iic-jku/SG13CMOS_SPARX/ToDo.md

## ToDo List

- [ ] Magic DRC: settle `MIM.e` and `MIM.i` upstream ([IHP-Open-PDK issue 1342](https://github.com/IHP-GmbH/IHP-Open-PDK/issues/1342)) and comment its lines back in (`magic-verify`, `make all`).
- [ ] gdscheck DRC: `make all` stops at `nSDB.e` of the `schottky` PCell until it is fixed in gdscheck ([gdscheck issue 53](https://github.com/aesc-silicon/gdscheck/issues/53)).
- [ ] top-level LVS: see [issue](https://github.com/IHP-GmbH/IHP-Open-PDK/issues/1041) for `Rmetal`, fixed by the open [PR 1121](https://github.com/IHP-GmbH/IHP-Open-PDK/pull/1121). Once it is merged, add `klayout-lvs` and `magic-lvs` of `sparx160_top` to `make all`, as the [Makefile Structure](README.md#makefile-structure) figure already shows. The LVS netlist targets look for `schematic/xschem/<CELL>.sch`, and there is no `sparx160_top.sch` (the top-level schematics are `sparx_top.sch` and `sparx_top_lvs.sch`): @simi1505
- [ ] WPD EM result: the committed `sparx160_wpd` Palace run (2026-07-29) predates `914c021`, which moved the port 2 and 3 markers to the output edges of the arms (same metal). Re-solve with `make sim-wpd-em`, refit the WPD models, rerun the WPD and composed-core benches and update the documentation numbers. On the current GDS at 160 GHz S21 is -3.37 dB instead of -4.42 dB and S11 -44.0 dB instead of -19.9 dB, and the fit is passive (largest singular value 0.999)
- [ ] EM metal model: the EM solves use gds2palace's surface metal, which reads the BPF about 0.5 dB too lossy and the WPD within 1 % ([check of 2026-10-18](verification/em/metal_model/README.md)). Switch to volume metal, or repeat the check, when one of the conditions in its section "When to revisit and switch to volume" holds.
- [ ] Container requirement for kpex: `klayout-pex` runs the kpex 2.5D engine since 2026-10-26 and needs kpex 0.7.0 or later, the `2026.10` image ships 0.6.8. IIC-OSIC-TOOLS `next_release` pins `klayout-pex==0.6.15` and the FEM plugins require `klayout-pex<0.7` (iic-jku/klayout-pex#499, 2026-11-06). Once an image ships 0.7.0 or later, move the requirement in `README.md`, `AGENTS.md` and `doc/index.qmd` to it when `next_release` is merged.
