iic-jku/SG13CMOS_SPARX/release/v.2.0.0/img/sparx160_top_black.png

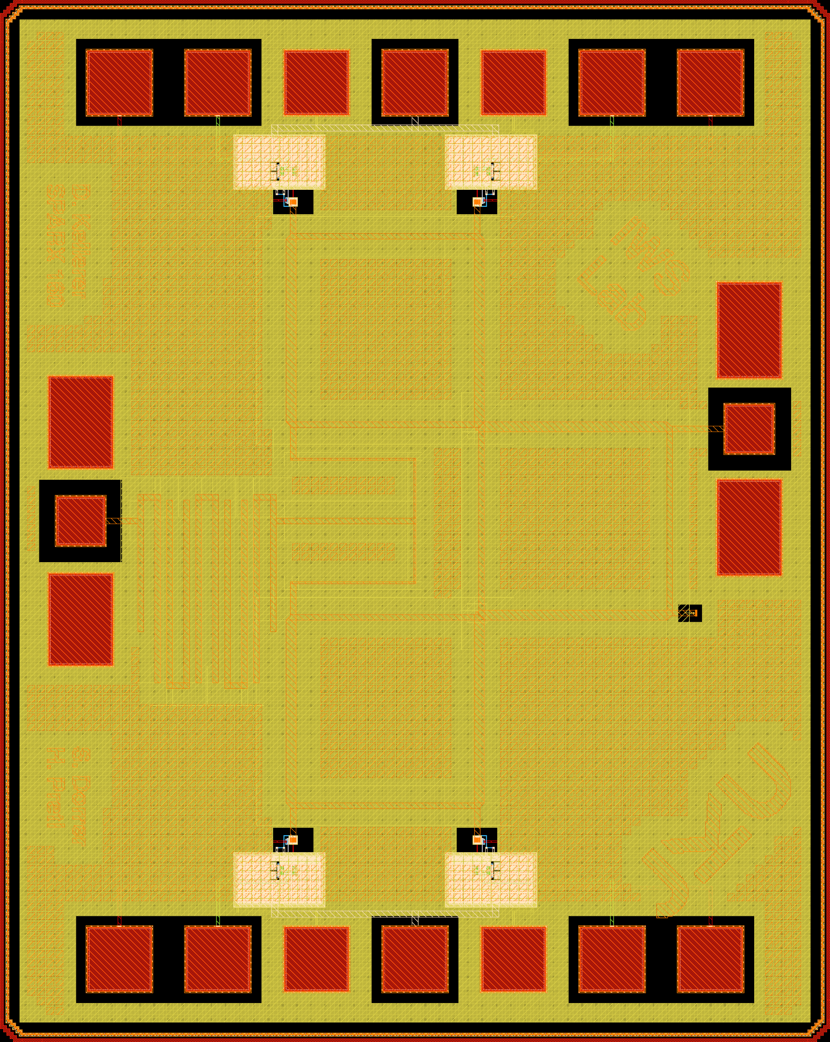
release/v.2.0.0/img/sparx160_top_black.png
