iic-jku/SG13CMOS_SPARX/render/img/sparx160_top_black.png

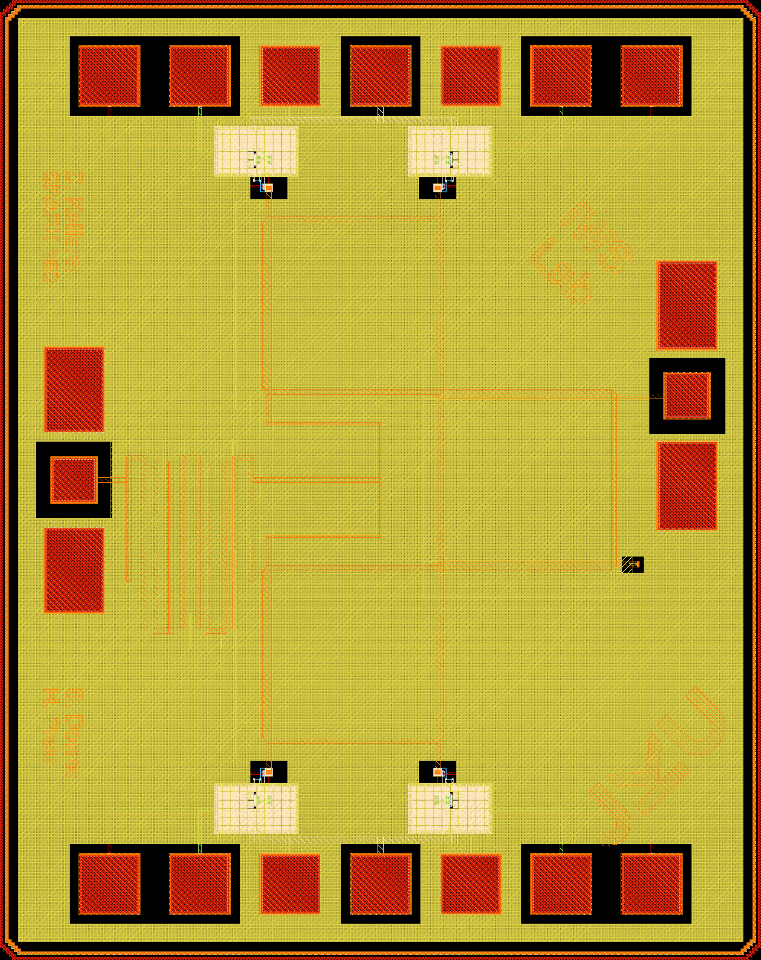
render/img/sparx160_top_black.png
