iic-jku/SG13CMOS_SPARX/measurements/README.md

# Measurements

- The LO & RF pads are measured with a wafer prober.
- The supply & power detector pads are bonded to a PCB and measured with an oscilloscope.
