iic-jku/SG13CMOS_SPARX/testbenches/xschem/plot_simulations/data/sparx_powdet_sbd_nf.csv

f_hz | asd_v | beta_f_vw | nep_w | nep_nopnp_w | g_usb | g_lsb | vif_dbv | nf_dsb_db | nf_ssb_db | nf_dsb_nopnp_db | asd_pumped_v | nf_dsb_quiescent_db | nf_ssb_quiescent_db | nf_dsb_quiescent_nopnp_db | g_usb_pac | g_lsb_pac | asd_pnoise_v | nf_dsb_pnoise_db
1.000000e+03 | 1.130809e-05 | 4.121629e+01 | 2.743597e-07 | 1.492750e-08 | 6.694820e-01 | 6.694820e-01 | -7.521049e+01 | 1.054971e+02 | 1.085074e+02 | 7.822756e+01 | 1.378732e-05 | 1.037753e+02 | 1.067856e+02 | 7.848862e+01 | 6.705324e-01 | 6.705324e-01 | 1.392545e-05 | 1.055769e+02
1.121999e+03 | 1.067562e-05 | 4.121629e+01 | 2.590146e-07 | 1.409269e-08 | 6.694820e-01 | 6.694820e-01 | -7.521049e+01 | 1.049972e+02 | 1.080075e+02 | 7.772770e+01 | 1.301619e-05 | 1.032754e+02 | 1.062857e+02 | 7.798876e+01 | 6.705324e-01 | 6.705324e-01 | 1.314659e-05 | 1.050770e+02
1.258881e+03 | 1.007853e-05 | 4.121629e+01 | 2.445277e-07 | 1.330458e-08 | 6.694820e-01 | 6.694820e-01 | -7.521049e+01 | 1.044973e+02 | 1.075076e+02 | 7.722785e+01 | 1.228818e-05 | 1.027754e+02 | 1.057857e+02 | 7.748890e+01 | 6.705324e-01 | 6.705324e-01 | 1.241129e-05 | 1.045770e+02
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
