iic-jku/SG13CMOS_SPARX/testbenches/xschem/plot_simulations/data/sparx_powdet_sbd_nf_compare.csv

f_hz | nf_dsb_transient_db | nf_dsb_hbnoise_db | nf_dsb_quiescent_db | nf_dsb_pnoise_db
2.034508e+08 | 5.064286e+01 | 5.157581e+01 | 4.930607e+01 | 5.167020e+01
3.051762e+08 | 4.947177e+01 | 4.966990e+01 | 4.727942e+01 | 4.976526e+01
4.069016e+08 | 4.730309e+01 | 4.838228e+01 | 4.592759e+01 | 4.847743e+01
5.086270e+08 | 4.711075e+01 | 4.741862e+01 | 4.491943e+01 | 4.751307e+01
6.103524e+08 | 4.678775e+01 | 4.665551e+01 | 4.412024e+01 | 4.674906e+01
7.120778e+08 | 4.634512e+01 | 4.601815e+01 | 4.345311e+01 | 4.611071e+01
8.138032e+08 | 4.613354e+01 | 4.548366e+01 | 4.289822e+01 | 4.557515e+01
9.155286e+08 | 4.585363e+01 | 4.501806e+01 | 4.242330e+01 | 4.510845e+01
1.017254e+09 | 4.445102e+01 | 4.460697e+01 | 4.201529e+01 | 4.469622e+01
1.118979e+09 | 4.350666e+01 | 4.423879e+01 | 4.166216e+01 | 4.432689e+01
1.220705e+09 | 4.376138e+01 | 4.391744e+01 | 4.137000e+01 | 4.400435e+01
1.322430e+09 | 4.331988e+01 | 4.362371e+01 | 4.111272e+01 | 4.370943e+01
1.424156e+09 | 4.332632e+01 | 4.335006e+01 | 4.088029e+01 | 4.343459e+01
1.525881e+09 | 4.377379e+01 | 4.310853e+01 | 4.068538e+01 | 4.319185e+01
1.627606e+09 | 4.345494e+01 | 4.288227e+01 | 4.050659e+01 | 4.296440e+01
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
