iic-jku/SG13CMOS_SPARX/testbenches/xschem/plot_simulations/data/sparx_powdet_sbd_nf_lo.csv

plo_dbm | nf_dsb_db | nf_dsb_nopnp_db | g_usb | s_out_pumped | nf_dsb_quiescent_db | nf_dsb_quiescent_nopnp_db | g_usb_pnoise | s_out_pnoise | nf_dsb_pnoise_db
-5.602060e+01 | 8.858381e+01 | 8.348676e+01 | 1.150324e-06 | 6.665798e-18 | 8.866429e+01 | 8.355086e+01 | 1.150004e-06 | 6.665712e-18 | 8.858494e+01
-5.270889e+01 | 8.527201e+01 | 8.017498e+01 | 2.466040e-06 | 6.665794e-18 | 8.535249e+01 | 8.023906e+01 | 2.465321e-06 | 6.665794e-18 | 8.527325e+01
-4.939717e+01 | 8.196035e+01 | 7.686323e+01 | 5.286606e-06 | 6.665965e-18 | 8.204072e+01 | 7.692729e+01 | 5.285070e-06 | 6.665966e-18 | 8.196159e+01
-4.608546e+01 | 7.864880e+01 | 7.355147e+01 | 1.133328e-05 | 6.666325e-18 | 7.872894e+01 | 7.361551e+01 | 1.133013e-05 | 6.666326e-18 | 7.864998e+01
-4.277375e+01 | 7.533742e+01 | 7.023963e+01 | 2.429647e-05 | 6.667087e-18 | 7.541706e+01 | 7.030363e+01 | 2.429034e-05 | 6.667089e-18 | 7.533849e+01
-3.946203e+01 | 7.202642e+01 | 6.692763e+01 | 5.208932e-05 | 6.668705e-18 | 7.210501e+01 | 6.699158e+01 | 5.207908e-05 | 6.668709e-18 | 7.202725e+01
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
