iic-jku/SG13CMOS_SPARX/testbenches/xschem/plot_simulations/data/sparx_powdet_sbd_nf_lo_m16.csv

plo_dbm | nf_dsb_db | nf_dsb_nopnp_db | g_usb | s_out_pumped | nf_dsb_quiescent_db | nf_dsb_quiescent_nopnp_db | g_usb_pnoise | s_out_pnoise | nf_dsb_pnoise_db
-5.602060e+01 | 6.917580e+01 | 6.747046e+01 | 3.481615e-05 | 2.326602e-18 | 6.924058e+01 | 6.752415e+01 | 3.475927e-05 | 2.326463e-18 | 6.918263e+01
-5.270889e+01 | 6.586971e+01 | 6.416570e+01 | 7.455526e-05 | 2.327077e-18 | 6.593361e+01 | 6.421718e+01 | 7.451310e-05 | 2.327070e-18 | 6.587215e+01
-4.939717e+01 | 6.255949e+01 | 6.085634e+01 | 1.598319e-04 | 2.327951e-18 | 6.262176e+01 | 6.090533e+01 | 1.597290e-04 | 2.327942e-18 | 6.256226e+01
-4.608546e+01 | 5.925049e+01 | 5.754863e+01 | 3.426061e-04 | 2.329193e-18 | 5.931044e+01 | 5.759401e+01 | 3.423827e-04 | 2.329179e-18 | 5.925329e+01
-4.277375e+01 | 5.594287e+01 | 5.424292e+01 | 7.343130e-04 | 2.330927e-18 | 5.599959e+01 | 5.428316e+01 | 7.338210e-04 | 2.330906e-18 | 5.594573e+01
-3.946203e+01 | 5.263739e+01 | 5.094033e+01 | 1.573511e-03 | 2.333287e-18 | 5.268972e+01 | 5.097330e+01 | 1.572396e-03 | 2.333257e-18 | 5.264041e+01
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
