iic-jku/SG13CMOS_SPARX/testbenches/xschem/plot_simulations/data/sparx_powdet_sbd_nf_lo_m1_pex.csv

plo_dbm | nf_dsb_db | nf_dsb_nopnp_db | g_usb | s_out_pumped | nf_dsb_quiescent_db | nf_dsb_quiescent_nopnp_db | g_usb_pnoise | s_out_pnoise | nf_dsb_pnoise_db
-5.602060e+01 | 8.942465e+01 | 8.448999e+01 | 5.841552e-07 | 4.113088e-18 | 8.950918e+01 | 8.455669e+01 | 5.839001e-07 | 4.113039e-18 | 8.942653e+01
-5.270889e+01 | 8.611285e+01 | 8.117821e+01 | 1.252296e-06 | 4.113085e-18 | 8.619739e+01 | 8.124490e+01 | 1.251735e-06 | 4.113085e-18 | 8.611484e+01
-4.939717e+01 | 8.280119e+01 | 7.786648e+01 | 2.684623e-06 | 4.113179e-18 | 8.288563e+01 | 7.793314e+01 | 2.683421e-06 | 4.113180e-18 | 8.280318e+01
-4.608546e+01 | 7.948963e+01 | 7.455473e+01 | 5.755206e-06 | 4.113377e-18 | 7.957385e+01 | 7.462136e+01 | 5.752694e-06 | 4.113378e-18 | 7.949156e+01
-4.277375e+01 | 7.617822e+01 | 7.124293e+01 | 1.233802e-05 | 4.113792e-18 | 7.626200e+01 | 7.130951e+01 | 1.233293e-05 | 4.113793e-18 | 7.618005e+01
-3.946203e+01 | 7.286714e+01 | 6.793098e+01 | 2.645121e-05 | 4.114670e-18 | 7.295000e+01 | 6.799751e+01 | 2.644163e-05 | 4.114672e-18 | 7.286876e+01
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
