iic-jku/SG13CMOS_SPARX/testbenches/xschem/plot_simulations/data/sparx_powdet_sbd_nf_m16.csv

f_hz | asd_v | beta_f_vw | nep_w | nep_nopnp_w | g_usb | g_lsb | vif_dbv | nf_dsb_db | nf_ssb_db | nf_dsb_nopnp_db | asd_pumped_v | nf_dsb_quiescent_db | nf_ssb_quiescent_db | nf_dsb_quiescent_nopnp_db | g_usb_pac | g_lsb_pac | asd_pnoise_v | nf_dsb_pnoise_db
1.000000e+03 | 5.685518e-06 | 2.507852e+02 | 2.267087e-08 | 3.261517e-09 | 4.424674e+00 | 4.424674e+00 | -6.700906e+01 | 8.405388e+01 | 8.706418e+01 | 7.146366e+01 | 3.001859e-06 | 8.960148e+01 | 9.261178e+01 | 7.276050e+01 | 4.452730e+00 | 4.452730e+00 | 2.940810e-06 | 8.384796e+01
1.121999e+03 | 5.367524e-06 | 2.507852e+02 | 2.140288e-08 | 3.079119e-09 | 4.424674e+00 | 4.424674e+00 | -6.700906e+01 | 8.355397e+01 | 8.656427e+01 | 7.096399e+01 | 2.833967e-06 | 8.910155e+01 | 9.211185e+01 | 7.226064e+01 | 4.452730e+00 | 4.452730e+00 | 2.776333e-06 | 8.334806e+01
1.258881e+03 | 5.067315e-06 | 2.507852e+02 | 2.020580e-08 | 2.906923e-09 | 4.424674e+00 | 4.424674e+00 | -6.700906e+01 | 8.305406e+01 | 8.606436e+01 | 7.046432e+01 | 2.675465e-06 | 8.860163e+01 | 9.161193e+01 | 7.176078e+01 | 4.452730e+00 | 4.452730e+00 | 2.621055e-06 | 8.284815e+01
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
