iic-jku/SG13CMOS_SPARX/testbenches/xschem/plot_simulations/figures/sparx_core_le_tb_tran_ngspice.png

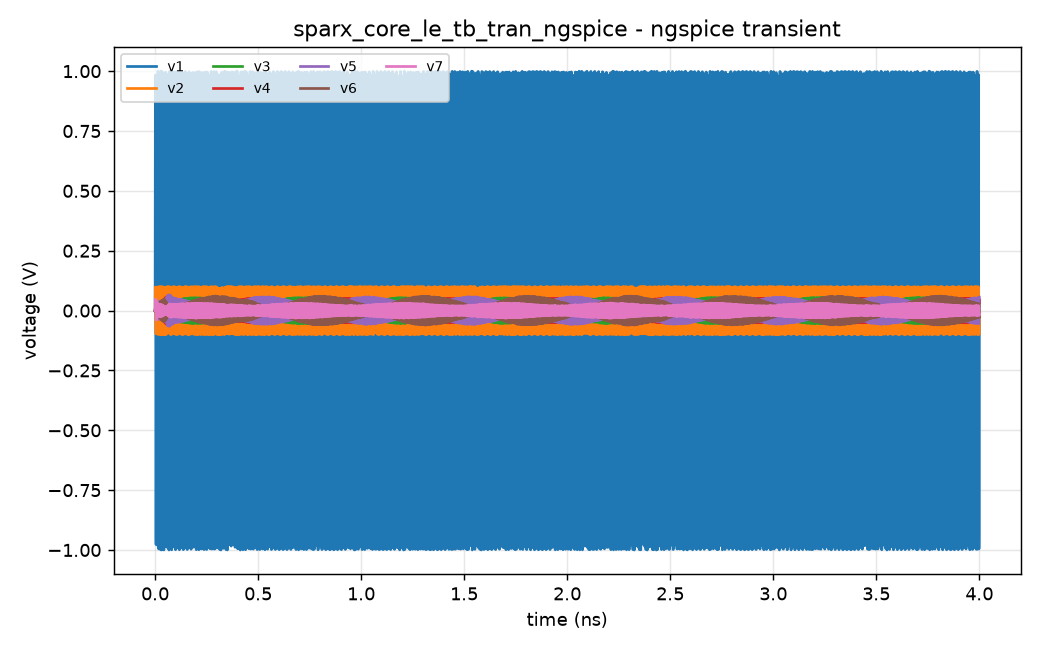
testbenches/xschem/plot_simulations/figures/sparx_core_le_tb_tran_ngspice.png
