iic-jku/SG13CMOS_SPARX/testbenches/xschem/plot_simulations/figures/sparx_core_tb_acsp_vacask.png

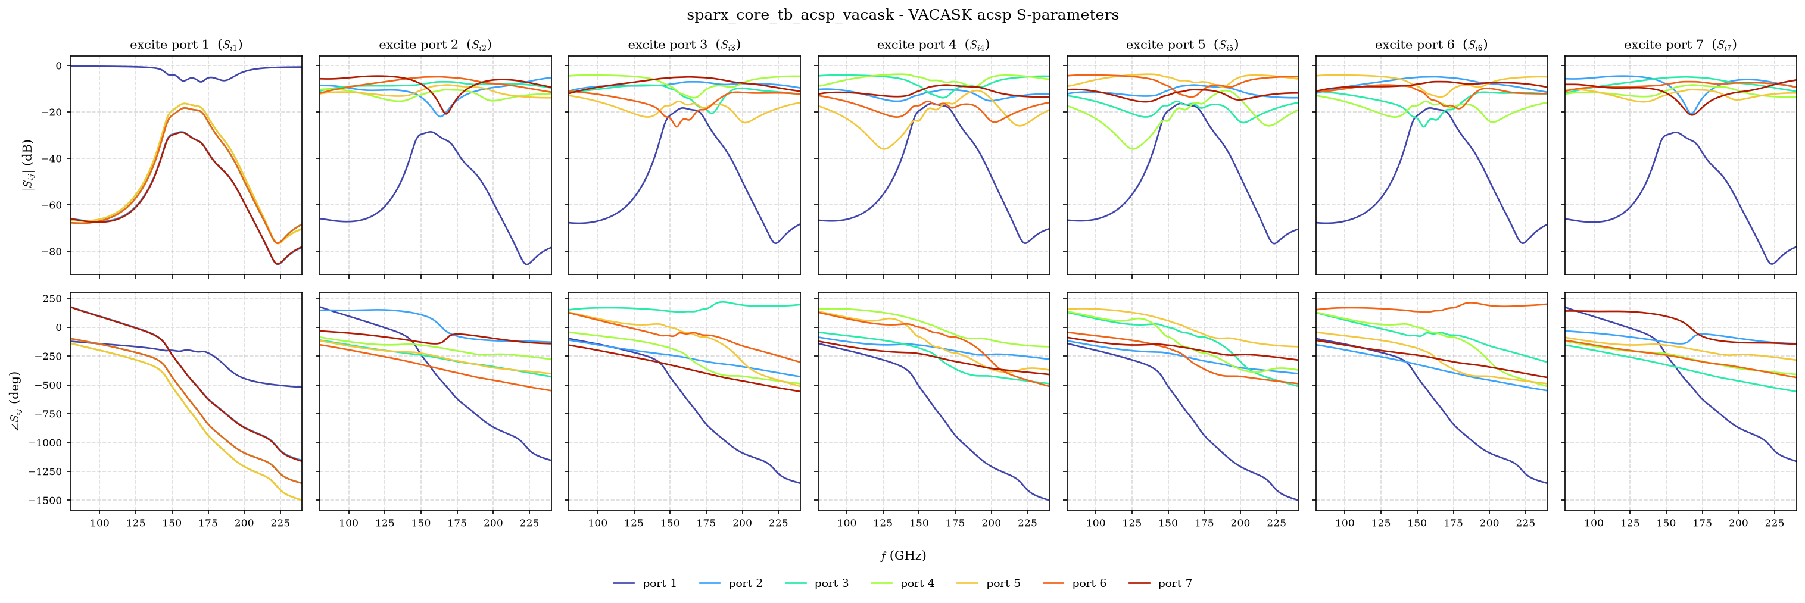
testbenches/xschem/plot_simulations/figures/sparx_core_tb_acsp_vacask.png
