iic-jku/SG13CMOS_SPARX/testbenches/xschem/plot_simulations/figures/sparx_powdet_sbd_hb_sweep_V-W.png

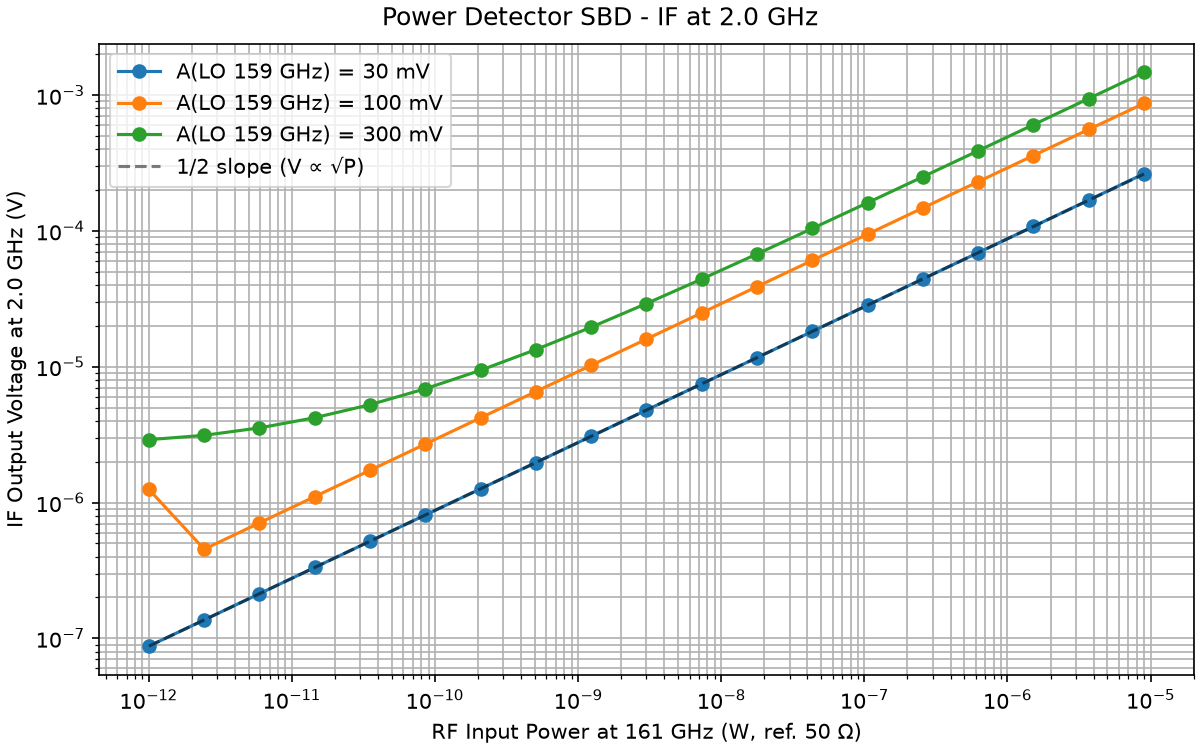
testbenches/xschem/plot_simulations/figures/sparx_powdet_sbd_hb_sweep_V-W.png
