iic-jku/SG13CMOS_SPARX/testbenches/xschem/plot_simulations/figures/sparx_powdet_sbd_nf_m16.png

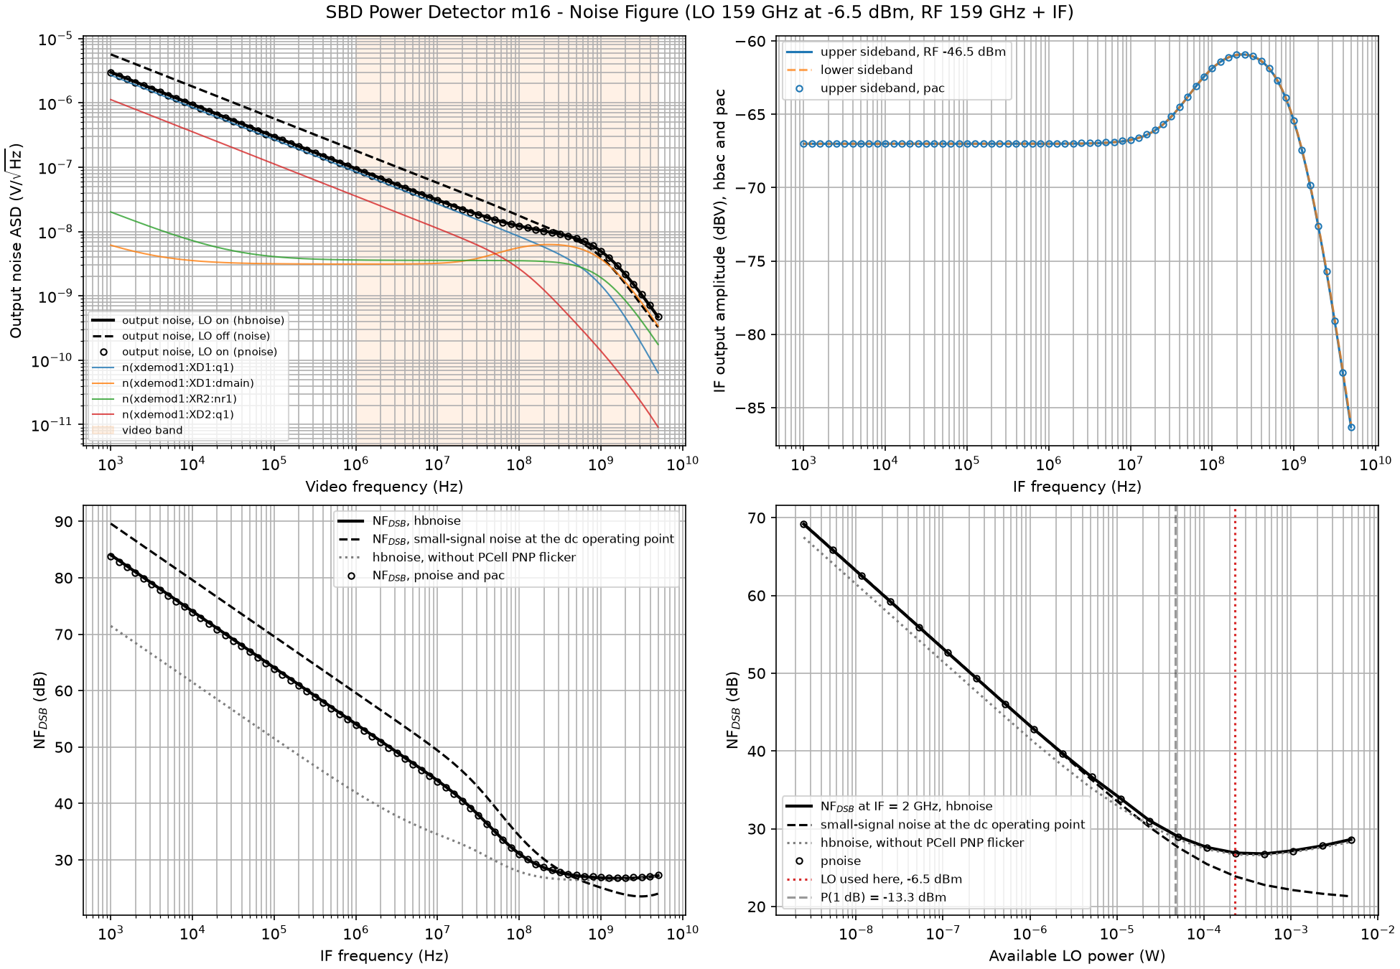
testbenches/xschem/plot_simulations/figures/sparx_powdet_sbd_nf_m16.png
