iic-jku/SG13CMOS_SPARX/testbenches/xschem/plot_simulations/figures/sparx_powdet_sbd_pss_sweep_c0_pex.png

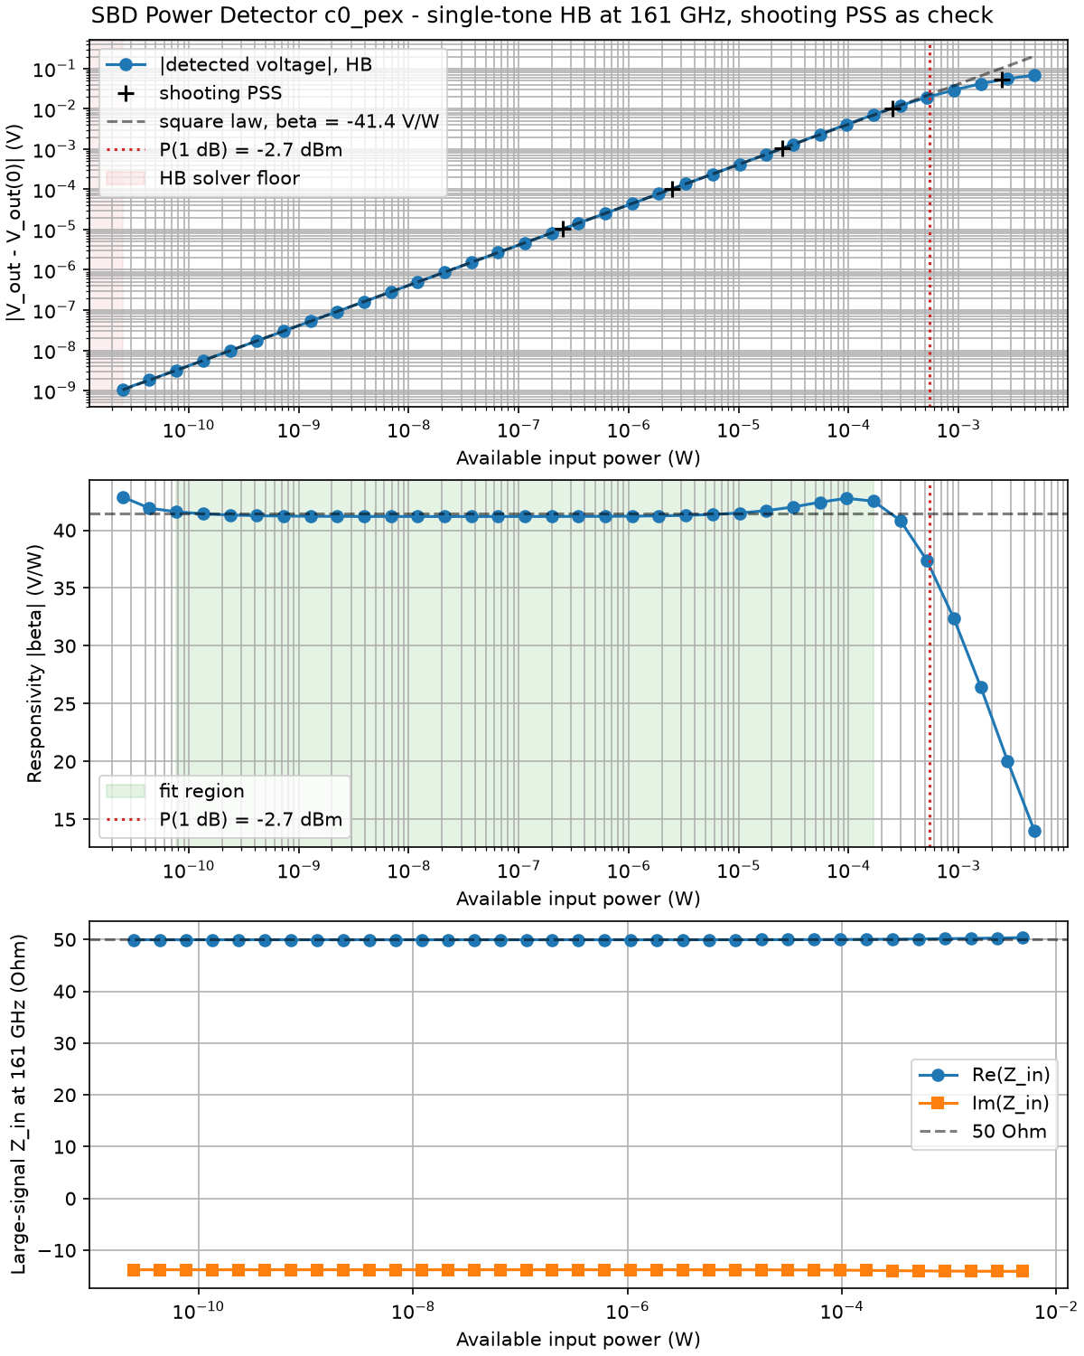
testbenches/xschem/plot_simulations/figures/sparx_powdet_sbd_pss_sweep_c0_pex.png
