iic-jku/SG13CMOS_SPARX/testbenches/xschem/plot_simulations/figures/sparx_powdet_sbd_tb_ngspice.png

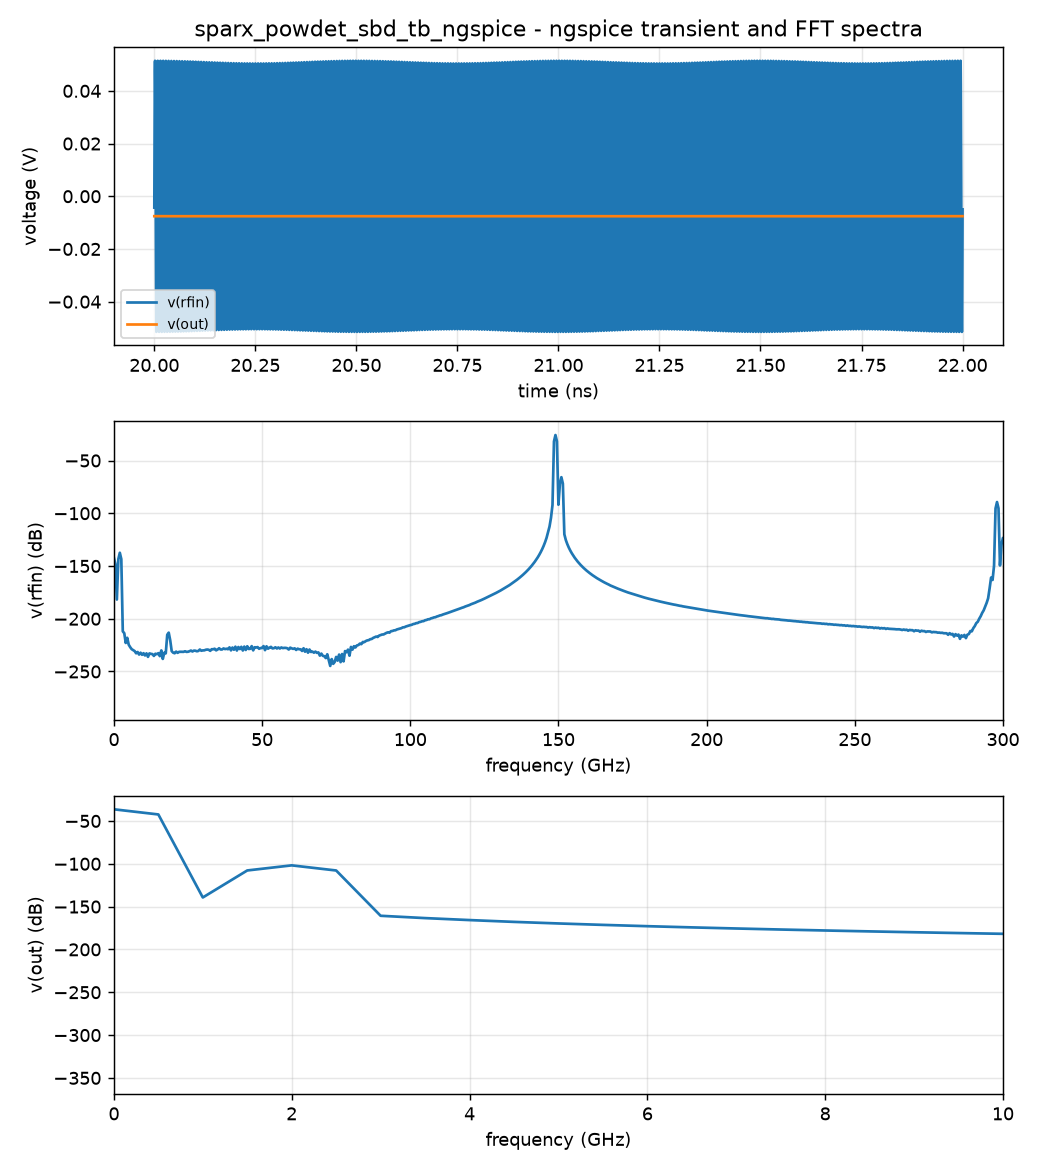
testbenches/xschem/plot_simulations/figures/sparx_powdet_sbd_tb_ngspice.png
