iic-jku/SG13CMOS_SPARX/testbenches/xschem/plot_simulations/figures/sparx_top_le_tn.png

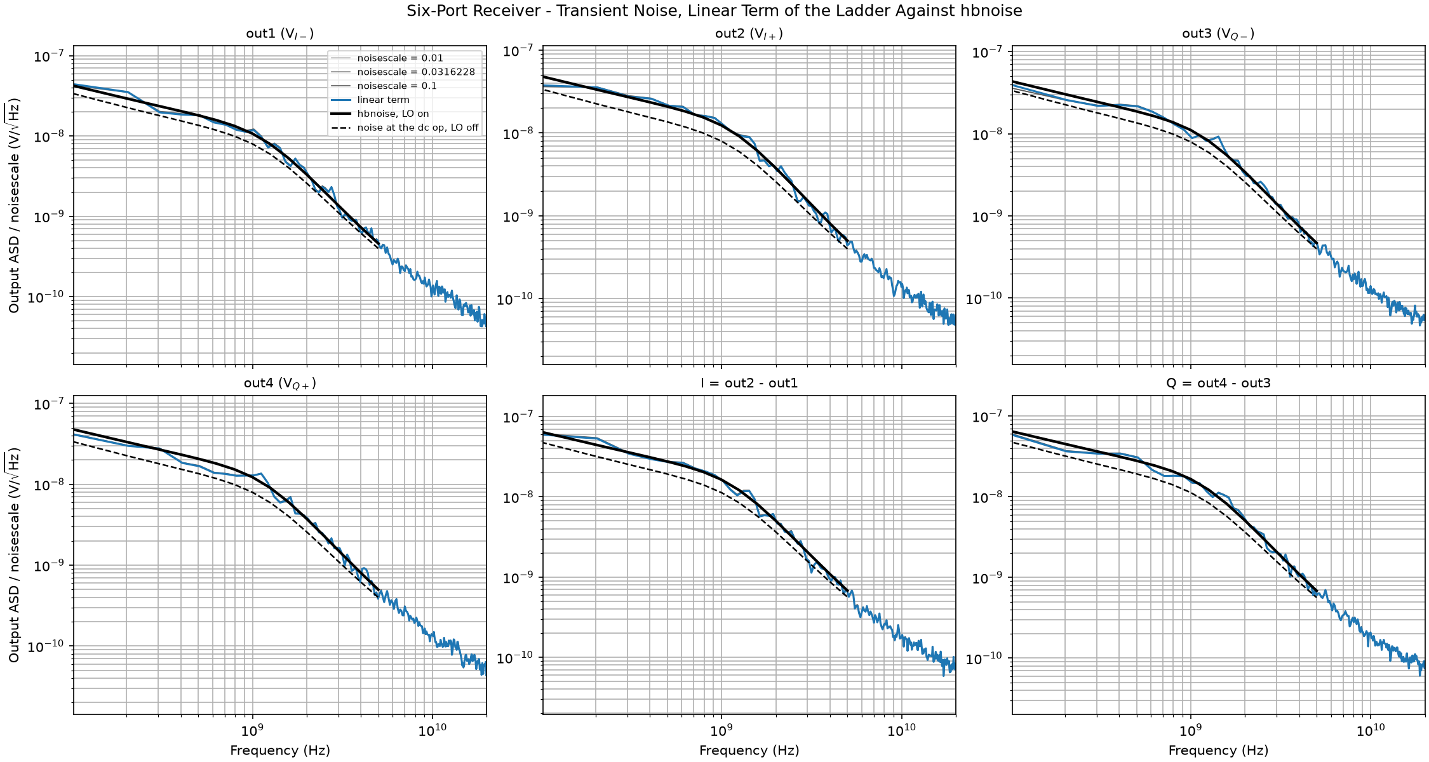
testbenches/xschem/plot_simulations/figures/sparx_top_le_tn.png
