iic-jku/SG13CMOS_SPARX/testbenches/xschem/plot_simulations/figures/sparx_wpd_le_tb_acsp_ngspice.png

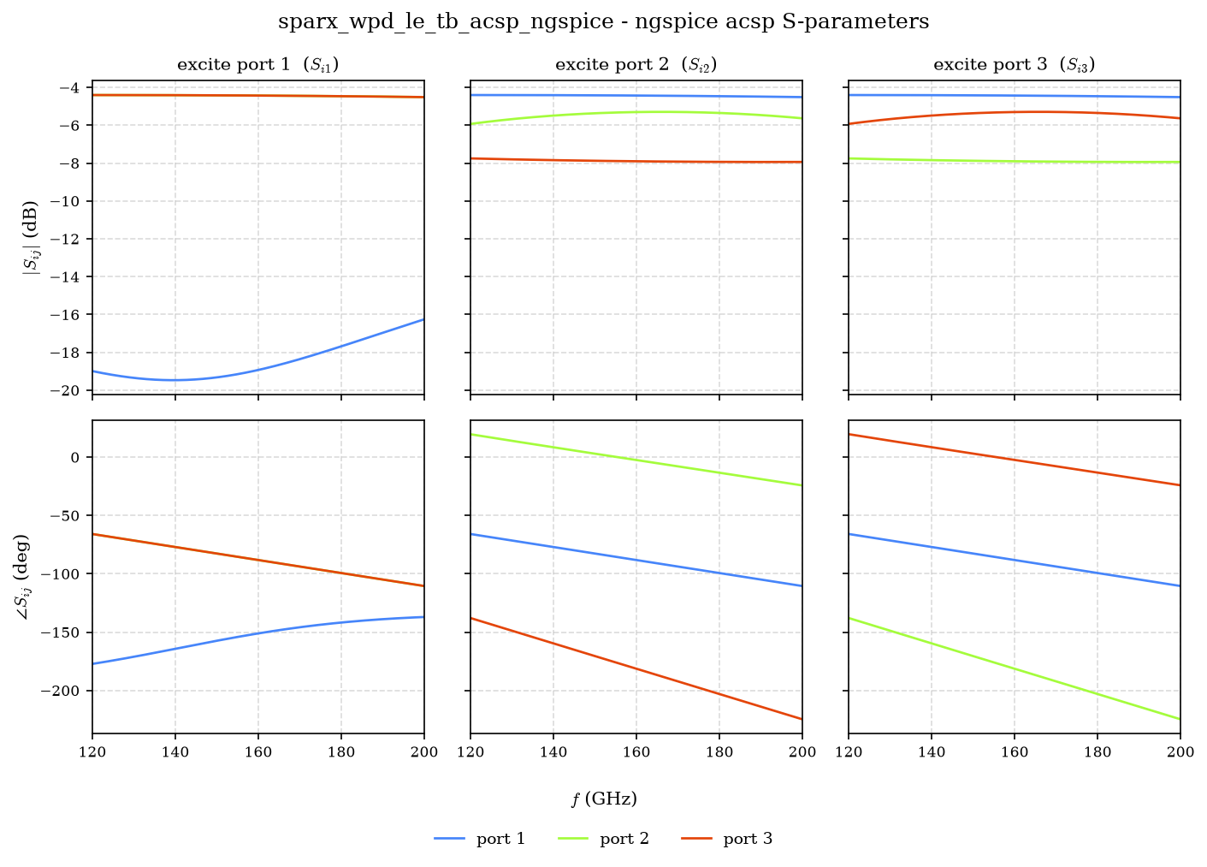
testbenches/xschem/plot_simulations/figures/sparx_wpd_le_tb_acsp_ngspice.png
