iic-jku/SG13CMOS_SPARX/doc/fig/sparx_blockdiagram/sparx_blockdiagram.pdf

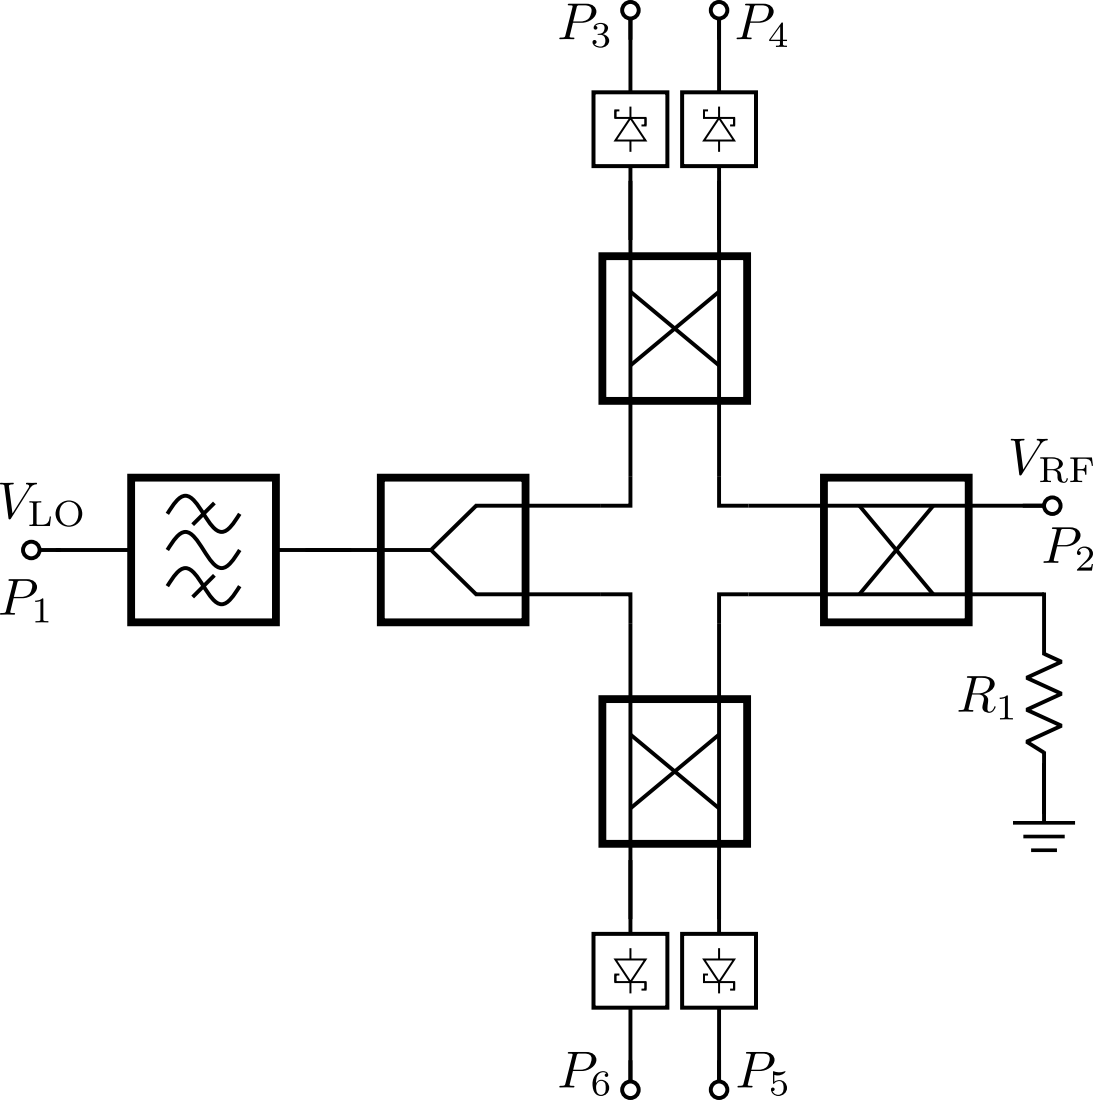
[picture p41: page 1]
