iic-jku/SG13CMOS_SPARX/netlist/spice/sparx_core_le.spice

* sparx_core_le - lumped-element equivalent (Ngspice / SPICE3)
* generated by snp2le
* EQUIVALENT CIRCUIT FOR VECTOR FITTED S-MATRIX
* Created using scikit-rf vectorFitting.py
* 
* 
* thermal noise of the passive: kT(I - S S^H) at the ports, from a spectral factor of this fit
* sources Rnz_e1..Rnz_e7 (0.25 ohm, the only noisy elements), 161 states nz_x*, controlled sources Gnz_*
.SUBCKT sparx_core_le p1 p2 p3 p4 p5 p6 p7
V1 p1 s1 0
R1 s1 0 50 noisy=0
Gd1_1 0 s1 p1 0 -0.002913191401
Fd1_1 0 s1 V1 -0.14565957
Gr1_re_1_1 0 s1 x1_re_a1 0 -681684.6204
Gr1_im_1_1 0 s1 x1_im_a1 0 -193017.7012
Gr2_1_1 0 s1 x2_a1 0 1.690031537
Gr3_re_1_1 0 s1 x3_re_a1 0 218871.3477
Gr3_im_1_1 0 s1 x3_im_a1 0 28370.06673
Gr4_re_1_1 0 s1 x4_re_a1 0 -55709.83268
Gr4_im_1_1 0 s1 x4_im_a1 0 358585.0299
Gr5_re_1_1 0 s1 x5_re_a1 0 -386285.1597
Gr5_im_1_1 0 s1 x5_im_a1 0 530108.9632
Gr6_re_1_1 0 s1 x6_re_a1 0 -911288.5966
Gr6_im_1_1 0 s1 x6_im_a1 0 -1477332.821
Gr7_re_1_1 0 s1 x7_re_a1 0 175365.6199
Gr7_im_1_1 0 s1 x7_im_a1 0 193816.5488
Gr8_re_1_1 0 s1 x8_re_a1 0 -337453.7
Gr8_im_1_1 0 s1 x8_im_a1 0 639438.242
Gr9_re_1_1 0 s1 x9_re_a1 0 539783.5979
Gr9_im_1_1 0 s1 x9_im_a1 0 1987898.741
Gr10_re_1_1 0 s1 x10_re_a1 0 347917.4973
Gr10_im_1_1 0 s1 x10_im_a1 0 -109390.5837
Gr11_re_1_1 0 s1 x11_re_a1 0 175974.6261
Gr11_im_1_1 0 s1 x11_im_a1 0 -630844.6317
Gr12_re_1_1 0 s1 x12_re_a1 0 527543.177
Gr12_im_1_1 0 s1 x12_im_a1 0 -251256.5977
Gd1_2 0 s1 p2 0 -7.062813979e-06
Fd1_2 0 s1 V2 -0.000353140699
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
Fx5_re_a3 0 x5_re_a3 V3 4.775459023e-06
Rp5_re_re_a3 0 x5_re_a3 1 noisy=0
Gp5_re_im_a3 0 x5_re_a3 x5_im_a3 0 1.86425479
Cx5_im_a3 x5_im_a3 0 2.551196837e-12
Gp5_im_re_a3 0 x5_im_a3 x5_re_a3 0 -1.86425479
Rp5_im_im_a3 0 x5_im_a3 1 noisy=0
Cx6_re_a3 x6_re_a3 0 4.347339998e-12
Gx6_re_a3 0 x6_re_a3 p3 0 7.959644309e-08
Fx6_re_a3 0 x6_re_a3 V3 3.979822155e-06
Rp6_re_re_a3 0 x6_re_a3 1 noisy=0
Gp6_re_im_a3 0 x6_re_a3 x6_im_a3 0 5.043445659
Cx6_im_a3 x6_im_a3 0 4.347339998e-12
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
