iic-jku/SG13CMOS_SPARX/netlist/pex/sparx_powdet_sbd_magic_pex_3.spice

* PEX produced on Sun Aug 30 02:50:36 PM CEST 2026 using /foss/tools/sak/sak-pex.sh with m=3 and s=1 (extresist threshold=1000 mOhm, minres=100 mOhm, mindelay=0 ps)
* NGSPICE file created from sparx_powdet_sbd_pex.ext - technology: ihp-sg13g2
* CORRECTED 2026-09-04 as a workaround for magic#557, which this extraction hits:
* the coupling capacitance of the m=3 full-RC run is emitted twice, and the substrate
* capacitance that extresist parks on internal nodes of the ground net is lost when
* scripts/powdet_variant.py idealises vss. The capacitance per net pair was rebuilt
* from an <extract all> plus <ext2spice hierarchy off> reference of the same layout.
* Devices and resistors are unchanged from the sak-pex.sh run named above, only the
* C lines differ. Post-layout responsivity moves 41.4 -> 38.8 V/W, the video
* bandwidth does not move. Regenerating with sak-pex.sh alone reintroduces the error.

.subckt sparx_powdet_sbd_pex vout vref vdd rfin vss
X0 vout.t6 dw_8122_4047# vdd.t16 vdd.t0 sg13_lv_pmos ad=0.95p pd=5.38u as=0.95p ps=5.38u w=5u l=0.13u
X1 a_8474_2725# vss.t42 cap_cmim l=10u w=10u
X2 vout.t18 dw_8122_4047# vss.t13 vss.t12 sg13_lv_nmos ad=0.475p pd=2.88u as=0.475p ps=2.88u w=2.5u l=0.13u
X3 vdd vss.t44 cap_cmim l=10u w=10u
X4 vdd vss.t44 cap_cmim l=10u w=10u
X5 vss.t21 dw_8122_4047# vout.t14 vss.t22 sg13_lv_nmos ad=0.475p pd=2.88u as=0.475p ps=2.88u w=2.5u l=0.13u
X6 a_8474_2725# vss.t42 cap_cmim l=10u w=10u
X7 vdd.t28 vdd.t26 vdd.t22 vdd.t0 sg13_lv_pmos ad=0.95p pd=5.38u as=0 ps=0 w=5u l=0.13u
X8 a_8474_2725# vss.t42 cap_cmim l=10u w=10u
X9 a_8474_2725# vss.t42 cap_cmim l=10u w=10u
X10 vss.t3 dw_8122_4047# vout.t15 vss.t19 sg13_lv_nmos ad=0.475p pd=2.88u as=0.475p ps=2.88u w=2.5u l=0.13u
X11 vout.t4 dw_8122_4047# vdd.t6 vdd.t0 sg13_lv_pmos ad=0.95p pd=5.38u as=0.95p ps=5.38u w=5u l=0.13u
X12 vdd vss.t44 cap_cmim l=10u w=10u
X13 vdd vss.t44 cap_cmim l=10u w=10u
X14 a_8474_2725# vss.t42 cap_cmim l=10u w=10u
X15 a_8474_2725# vss.t42 cap_cmim l=10u w=10u
X16 vout.t12 dw_8122_4047# vss.t33 vss.t32 sg13_lv_nmos ad=0.475p pd=2.88u as=0.475p ps=2.88u w=2.5u l=0.13u
X17 vout.t3 dw_8122_4047# vdd.t4 vdd.t0 sg13_lv_pmos ad=0.95p pd=5.38u as=0.95p ps=5.38u w=5u l=0.13u
X18 vdd.t1 dw_9390_4047# vref.t0 vdd.t0 sg13_lv_pmos ad=0.95p pd=5.38u as=0.95p ps=5.38u w=5u l=0.13u
X19 vout.t2 dw_8122_4047# vdd.t20 vdd.t0 sg13_lv_pmos ad=0.95p pd=5.38u as=0.95p ps=5.38u w=5u l=0.13u
X20 vss.t5 dw_8122_4047# vout.t5 vss.t4 sg13_lv_nmos ad=0.475p pd=2.88u as=0.475p ps=2.88u w=2.5u l=0.13u
X21 vout.t9 dw_8122_4047# vss.t1 vss.t18 sg13_lv_nmos ad=0.475p pd=2.88u as=0.475p ps=2.88u w=2.5u l=0.13u
X22 vdd vss.t44 cap_cmim l=9u w=6.8u
X23 vdd vss.t44 cap_cmim l=10u w=10u
X24 vdd vss.t42 cap_cmim l=10u w=10u
X25 a_8474_2725# vss.t42 cap_cmim l=10u w=10u
X26 vout.t1 dw_8122_4047# vdd.t18 vdd.t0 sg13_lv_pmos ad=0.95p pd=5.38u as=0.95p ps=5.38u w=5u l=0.13u
X27 a_8474_2725# vss.t42 cap_cmim l=10u w=10u
X28 vss.t27 dw_8122_4047# vout.t11 vss.t28 sg13_lv_nmos ad=0.475p pd=2.88u as=0.475p ps=2.88u w=2.5u l=0.13u
X29 vout.t13 dw_8122_4047# vss.t16 vss.t15 sg13_lv_nmos ad=0.475p pd=2.88u as=0.475p ps=2.88u w=2.5u l=0.13u
X30 a_8474_2725# vss.t42 cap_cmim l=10u w=10u
X31 vdd vss.t44 cap_cmim l=10u w=10u
X32 a_8474_2725# vss.t42 cap_cmim l=10u w=10u
X33 a_8474_2725# vss.t42 cap_cmim l=10u w=10u
X34 vss.t24 dw_8122_4047# vout.t10 vss.t25 sg13_lv_nmos ad=0.475p pd=2.88u as=0.475p ps=2.88u w=2.5u l=0.13u
X35 vdd vss.t44 cap_cmim l=10u w=10u
X36 a_8474_2725# vss.t42 cap_cmim l=10u w=10u
X37 a_8474_2725# vss.t42 cap_cmim l=10u w=10u
X38 rfin a_8232_4131# cap_cmim l=10u w=10u
X39 a_8474_2725# vss.t42 cap_cmim l=10u w=10u
X40 vdd vss.t44 cap_cmim l=10u w=10u
X41 a_8474_2725# vdd.t23 vss.t41 rhigh l=2u w=0.5u
X42 vout.t8 dw_8122_4047# vdd.t8 vdd.t0 sg13_lv_pmos ad=0.95p pd=5.38u as=0.95p ps=5.38u w=5u l=0.13u
X43 a_8232_4131# dw_8122_4047# vss schottky_nbl1 l=1.2u w=2.655u
X44 vdd.t14 dw_8122_4047# vout.t6 vdd.t0 sg13_lv_pmos ad=0.95p pd=5.38u as=0.95p ps=5.38u w=5u l=0.13u
X45 vss.t10 dw_8122_4047# vout.t18 vss.t11 sg13_lv_nmos ad=0.475p pd=2.88u as=0.475p ps=2.88u w=2.5u l=0.13u
X46 vdd vss.t44 cap_cmim l=10u w=10u
X47 vdd.t2 dw_8122_4047# vout.t7 vdd.t0 sg13_lv_pmos ad=0.95p pd=5.38u as=0.95p ps=5.38u w=5u l=0.13u
X48 a_8474_2725# vss.t42 cap_cmim l=10u w=10u
X49 vout.t15 dw_8122_4047# vss.t21 vss.t20 sg13_lv_nmos ad=0.475p pd=2.88u as=0.475p ps=2.88u w=2.5u l=0.13u
X50 vss.t7 dw_8122_4047# vout.t17 vss.t8 sg13_lv_nmos ad=0.475p pd=2.88u as=0.475p ps=2.88u w=2.5u l=0.13u
X51 vout.t16 dw_8122_4047# vdd.t22 vdd.t0 sg13_lv_pmos ad=0.95p pd=5.38u as=0.95p ps=5.38u w=5u l=0.13u
X52 a_9398_3295# a_8474_2725# vss.t74 rsil l=2.5u w=0.5u
X53 vref.t1 dw_9390_4047# vss.t3 vss.t2 sg13_lv_nmos ad=0.475p pd=2.88u as=0.475p ps=2.88u w=2.5u l=0.13u
X54 vdd vss.t44 cap_cmim l=10u w=10u
X55 vss.t30 dw_8122_4047# vout.t12 vss.t31 sg13_lv_nmos ad=0.475p pd=2.88u as=0.475p ps=2.88u w=2.5u l=0.13u
X56 dw_9390_4047# vref.t2 vss.t34 rppd l=1.5u w=0.5u
X57 vdd vss.t44 cap_cmim l=10u w=10u
X58 vdd.t3 dw_8122_4047# vout.t3 vdd.t0 sg13_lv_pmos ad=0.95p pd=5.38u as=0.95p ps=5.38u w=5u l=0.13u
X59 vdd vss.t42 cap_cmim l=10u w=10u
X60 vout.t0 dw_8122_4047# vdd.t1 vdd.t0 sg13_lv_pmos ad=0.95p pd=5.38u as=0.95p ps=5.38u w=5u l=0.13u
X61 vss.t37 vss.t35 vss.t5 vss.t36 sg13_lv_nmos ad=0.85p pd=5.68u as=0 ps=0 w=2.5u l=0.13u
X62 a_8474_2725# vss.t42 cap_cmim l=10u w=10u
X63 vdd.t18 dw_8122_4047# vout.t2 vdd.t0 sg13_lv_pmos ad=0.95p pd=5.38u as=0.95p ps=5.38u w=5u l=0.13u
X64 vout.t19 dw_8122_4047# vdd.t10 vdd.t0 sg13_lv_pmos ad=0.95p pd=5.38u as=0.95p ps=5.38u w=5u l=0.13u
X65 vss.t16 dw_8122_4047# vout.t9 vss.t17 sg13_lv_nmos ad=0.475p pd=2.88u as=0.475p ps=2.88u w=2.5u l=0.13u
X66 vdd vss.t42 cap_cmim l=10u w=10u
X67 vout.t20 dw_8122_4047# vss.t34 rppd l=1.5u w=0.5u
X68 vdd vss.t44 cap_cmim l=10u w=10u
X69 a_8474_2725# vss.t42 cap_cmim l=10u w=10u
X70 vdd vss.t44 cap_cmim l=10u w=10u
X71 a_8474_2725# vss.t42 cap_cmim l=10u w=10u
X72 vdd.t16 dw_8122_4047# vout.t1 vdd.t0 sg13_lv_pmos ad=0.95p pd=5.38u as=0.95p ps=5.38u w=5u l=0.13u
X73 a_8474_2725# vss.t42 cap_cmim l=10u w=10u
X74 vss.t13 dw_8122_4047# vout.t13 vss.t14 sg13_lv_nmos ad=0.475p pd=2.88u as=0.475p ps=2.88u w=2.5u l=0.13u
X75 a_8474_2725# vss.t42 cap_cmim l=10u w=10u
X76 vdd vss.t44 cap_cmim l=10u w=10u
X77 a_8474_2725# vss.t42 cap_cmim l=10u w=10u
X78 vout.t14 dw_8122_4047# vss.t24 vss.t23 sg13_lv_nmos ad=0.475p pd=2.88u as=0.475p ps=2.88u w=2.5u l=0.13u
X79 a_8474_2725# vss.t42 cap_cmim l=10u w=10u
X80 vdd vss.t44 cap_cmim l=10u w=10u
X81 vdd.t6 dw_8122_4047# vout.t8 vdd.t0 sg13_lv_pmos ad=0.95p pd=5.38u as=0.95p ps=5.38u w=5u l=0.13u
X82 vdd vss.t44 cap_cmim l=10u w=10u
X83 vss.t33 vss.t38 vss.t40 vss.t39 sg13_lv_nmos ad=0.475p pd=2.88u as=0 ps=0 w=2.5u l=0.13u
X84 a_8474_2725# vss.t42 cap_cmim l=10u w=10u
X85 vdd vss.t44 cap_cmim l=9u w=6.8u
X86 vout.t7 dw_8122_4047# vdd.t14 vdd.t0 sg13_lv_pmos ad=0.95p pd=5.38u as=0.95p ps=5.38u w=5u l=0.13u
X87 vdd vss.t44 cap_cmim l=10u w=10u
X88 vdd.t4 dw_8122_4047# vout.t4 vdd.t0 sg13_lv_pmos ad=0.95p pd=5.38u as=0.95p ps=5.38u w=5u l=0.13u
X89 vout.t17 dw_8122_4047# vss.t10 vss.t9 sg13_lv_nmos ad=0.475p pd=2.88u as=0.475p ps=2.88u w=2.5u l=0.13u
X90 a_8474_2725# vss.t42 cap_cmim l=10u w=10u
X91 vref.t0 dw_9390_4047# vdd.t2 vdd.t0 sg13_lv_pmos ad=0.95p pd=5.38u as=0.95p ps=5.38u w=5u l=0.13u
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
C80 vout.n3 vss 0.486563f
C81 vout.t1 vss 0.19346f
C82 vout.n4 vss 0.273404f
C83 vout.t6 vss 3.80559f
C84 vout.n5 vss 0.273412f
C85 vout.t7 vss 0.175718f
C86 vout.n6 vss 0.510612f
C87 vout.t4 vss 0.175714f
C88 vout.t19 vss 0.175718f
C89 vout.t0 vss 0.175718f
C90 vout.t8 vss 0.175714f
C91 vout.t3 vss 0.175714f
C92 vout.n7 vss 1.91055f
C93 vout.t20 vss 0.0616759f
C94 vout.t17 vss 0.0891768f
C95 vout.t13 vss 0.0891768f
C96 vout.t15 vss 0.0894355f
C97 vout.t14 vss 0.0891768f
C98 vout.t10 vss 0.0891768f
C99 vout.t11 vss 0.0891768f
C100 vout.t12 vss 0.0903329f
C101 vout.n8 vss 0.25799f
C102 vout.t9 vss 0.0891768f
C103 vout.t18 vss 0.0891768f
C104 vout.t5 vss 0.0891768f
C105 vout.n9 vss 1.62907f
C106 vref.t0 vss 1.03435f
C107 vref.t1 vss 0.0731088f
C108 vref.n0 vss 0.392249f
C109 vref.t2 vss 0.0471537f
C110 vref.n1 vss 0.48784f
Cfix0 a_8474_2725# vss 56.9921f
Cfix1 a_9398_3295# vss 0.89308f
Cfix2 dw_8122_4047# vss 11.656f
Cfix3 rfin vss 3.22536f
.ends
