iic-jku/SG13CMOS_SPARX/netlist/spice/blc_le.spice

* blc_le - lumped-element equivalent (Ngspice / SPICE3)
* generated by snp2le
* EQUIVALENT CIRCUIT FOR VECTOR FITTED S-MATRIX
* Created using scikit-rf vectorFitting.py
* 
* 
.SUBCKT blc_le p1 p2 p3 p4
V1 p1 s1 0
R1 s1 0 50
Gd1_1 0 s1 p1 0 -0.00135903038
Fd1_1 0 s1 V1 -0.06795151899
Gr1_re_1_1 0 s1 x1_re_a1 0 -466102.2317
Gr1_im_1_1 0 s1 x1_im_a1 0 -83272.7305
Gr2_re_1_1 0 s1 x2_re_a1 0 139727.8544
Gr2_im_1_1 0 s1 x2_im_a1 0 -492632.0781
Gr3_re_1_1 0 s1 x3_re_a1 0 337054.193
Gr3_im_1_1 0 s1 x3_im_a1 0 -240793.1822
Gd1_2 0 s1 p2 0 0.001064045615
Fd1_2 0 s1 V2 0.05320228073
Gr1_re_1_2 0 s1 x1_re_a2 0 -285620.5483
Gr1_im_1_2 0 s1 x1_im_a2 0 -281808.9666
Gr2_re_1_2 0 s1 x2_re_a2 0 264463.2381
Gr2_im_1_2 0 s1 x2_im_a2 0 -6580.419213
Gr3_re_1_2 0 s1 x3_re_a2 0 96732.57859
Gr3_im_1_2 0 s1 x3_im_a2 0 -564472.4499
Gd1_3 0 s1 p3 0 -0.0008051656617
Fd1_3 0 s1 V3 -0.04025828309
Gr1_re_1_3 0 s1 x1_re_a3 0 242930.7388
Gr1_im_1_3 0 s1 x1_im_a3 0 -233454.3812
Gr2_re_1_3 0 s1 x2_re_a3 0 -157092.2518
Gr2_im_1_3 0 s1 x2_im_a3 0 636552.9974
Gr3_re_1_3 0 s1 x3_re_a3 0 -304552.5846
Gr3_im_1_3 0 s1 x3_im_a3 0 216608.6521
Gd1_4 0 s1 p4 0 -0.003097367713
Fd1_4 0 s1 V4 -0.1548683856
Gr1_re_1_4 0 s1 x1_re_a4 0 165199.8513
Gr1_im_1_4 0 s1 x1_im_a4 0 -157622.1514
Gr2_re_1_4 0 s1 x2_re_a4 0 -184383.0743
Gr2_im_1_4 0 s1 x2_im_a4 0 -417784.8992
Gr3_re_1_4 0 s1 x3_re_a4 0 -136337.8753
Gr3_im_1_4 0 s1 x3_im_a4 0 464043.5166
Cx1_re_a1 x1_re_a1 0 1.399967176e-12
Gx1_re_a1 0 x1_re_a1 p1 0 8.64148994e-08
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
Gx3_re_a4 0 x3_re_a4 p4 0 5.940927442e-08
Fx3_re_a4 0 x3_re_a4 V4 2.970463721e-06
Rp3_re_re_a4 0 x3_re_a4 1
Gp3_re_im_a4 0 x3_re_a4 x3_im_a4 0 3.14158227
Cx3_im_a4 x3_im_a4 0 3.025545542e-12
Gp3_im_re_a4 0 x3_im_a4 x3_re_a4 0 -3.14158227
Rp3_im_im_a4 0 x3_im_a4 1
.ENDS blc_le
