iic-jku/SG13CMOS_SPARX/(commit log)

2026-06-01 updated testbenches
    [sparx_powdet_sbd_tb.sch, sparx_powdet_sbd_tb_vacask.sch]
2026-06-02 updated testbenches and added eval scripts
    [sparx_powdet_sbd_tb_hb_vacask.sch, sparx_powdet_sbd_tb_tn_vacask.sch]
2026-06-19 updated HB simulation and added results
    [sparx_powdet_sbd_hb_sweep_alo_100mV.csv, sparx_powdet_sbd_hb_sweep_alo_300mV.csv, sparx_powdet_sbd_hb_sweep_alo_30mV.csv, sparx_powdet_sbd_hb_sweep_ref.csv]
2026-07-04 added Ngspice testbenches
    [sparx_blc_le_tb_acsp_ngspice.sch, sparx_bpf_le_tb_acsp_ngspice.sch, sparx_wpd_le_tb_acsp_ngspice.sch]
2026-07-04 added VACASK testbenches
    [sparx_blc_le_tb_acsp_vacask.sch, sparx_bpf_le_tb_acsp_vacask.sch, sparx_wpd_le_tb_acsp_vacask.sch]
2026-07-04 added transient noise VACASK testbench
    [sparx_powdet_sbd_tb_tn_vacask.sch]
2026-07-04 added HB VACASK testbench
    [sparx_powdet_sbd_tb_hb_tf_vacask.sch]
2026-07-04 updated sparx_powdet_sbd.sch / .sym
    [sparx_powdet_sbd.sch]
2026-07-04 added top-level schematics and symbols
    [sparx_lvs_top.sch, sparx_top.sch]
2026-07-04 renamed `sparx_lvs_top` to `sparx_top_lvs`
    [sparx_top_lvs.sch]
2026-07-04 added `sparx_core.sch` and `sparx_core.sym`
    [sparx_core.sch]
2026-07-04 updated `sparx_core.sch`
    [sparx_core.sch]
2026-07-04 added `sparx_core_tb_acsp_ngspice.sch`
    [sparx_core_tb_acsp_ngspice.sch]
2026-07-04 added `sparx_core_le_tb_acsp_ngspice.sch`
    [sparx_core_le_tb_acsp_ngspice.sch]
2026-07-04 added `sparx_top_tb_tran_ngspice.sch`
    [sparx_top_tb_tran_ngspice.sch]
2026-07-05 relocated / renamed files in `verification/em` folder
    [domain-E.csv, error-indicators.csv, port-I.csv, port-S.csv, port-V.csv]
2026-07-05 relocated simulation VACASK Python scripts
    [sparx_blc_le_tb_acsp_vacask.sch, sparx_bpf_le_tb_acsp_vacask.sch, sparx_powdet_sbd_tb_hb_tf_vacask.sch, sparx_powdet_sbd_tb_hb_vacask.sch, sparx_powdet_sbd_tb_tn_vacask.sch, sparx_wpd_le_tb_acsp_vacask.sch]
2026-07-05 renamed `sparx_powdet_sbd_tb_ngspice.sch`
    [sparx_powdet_sbd_tb_ngspice.sch]
2026-07-08 updated WPD and BLC testbenches
    [sparx_blc_le_tb_acsp_ngspice.sch, sparx_blc_le_tb_acsp_vacask.sch, sparx_wpd_le_tb_acsp_ngspice.sch, sparx_wpd_le_tb_acsp_vacask.sch]
2026-07-08 added WPD and BLC transient testbenches
    [sparx_blc_le_tb_tran_ngspice.sch, sparx_wpd_le_tb_tran_ngspice.sch]
2026-07-08 added top-level Ngspice transient simulation
    [sparx_core_le_tb_acsp_ngspice.sch, sparx_core_le_tb_tran_ngspice.sch, sparx_core_tb_acsp_ngspice.sch, sparx_top.sch, sparx_top_le.sch, sparx_top_le_tb_tran_ngspice.sch]
2026-07-14 removed `ntap` / `ptap` from `sparx_powdet_sbd.sch`
    [sparx_powdet_sbd.sch]
2026-07-14 reran snp2le and simulations of BPF, WPD and BLC with de-embedded
2026-07-14 unwrapped phase in testbenches
    [sparx_blc_le_tb_acsp_ngspice.sch, sparx_bpf_le_tb_acsp_ngspice.sch, sparx_core_le_tb_acsp_ngspice.sch, sparx_core_tb_acsp_ngspice.sch, sparx_wpd_le_tb_acsp_ngspice.sch]
2026-07-14 added `sparx_core_le_tb_acsp_vacask.sch` and `sparx_core_tb_acsp_vacask.sch` testbenches
    [sparx_core_le_tb_acsp_vacask.sch, sparx_core_tb_acsp_vacask.sch]
2026-07-14 fixed phase imbalance in Xschem testbenches
    [sparx_core_le_tb_acsp_ngspice.sch, sparx_core_tb_acsp_ngspice.sch]
2026-07-14 archived some testbenches
    [sparx_powdet_sbd_tb_hb_tf_vacask.sch, sparx_powdet_sbd_tb_tn_vacask.sch]
2026-07-14 updated `sparx_core_le_tb_acsp_ngspice.sch` and `sparx_core_tb_acsp_ngspice.sch` with all s-parameter export
    [sparx_core_le_tb_acsp_ngspice.sch, sparx_core_tb_acsp_ngspice.sch]
2026-07-14 updated copyright headers
    [sparx_blc_le_tb_acsp_ngspice.sch, sparx_blc_le_tb_acsp_vacask.sch, sparx_blc_le_tb_tran_ngspice.sch, sparx_bpf_le_tb_acsp_ngspice.sch, sparx_bpf_le_tb_acsp_vacask.sch, sparx_core.sch, sparx_core_le_tb_acsp_ngspice.sch, sparx_core_le_tb_acsp_vacask.sch]
2026-07-15 sparx160_core drc clean (except slit M5) with DBU 1nm
    The slit violation is okay and is fixed later into the layout.
2026-07-15 pd + toplevel gds DRC clean (as far as possible) with dbu set to 1nm (IHP TO branch)
2026-07-15 adapted `six_port_gen.py` to deterministic PDK port naming (gdsfactory 9.45)
    The container update (gdsfactory 9.45 / new kfactory+KLayout) changed the
    box enumeration order that auto-names the DS_/G_ ports of the PDK mos
    cells. The script's hardcoded port names and list indices then picked the
    wrong fingers/gates: the short drain via stack was never placed, the
    output_stage bbox grew, the pmos landed misplaced/rotated and vout/vref/
    vss shorted -- both KLayout and Magic+Netgen LVS failed on regeneration.
    Companion change in IHP-GDSFactory-Addon (`ihp/cells/mos_transistors.py`):
    DS_/G_ ports are now renumbered positionally left to right, so the names
    below are stable across tool versions.
    C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
2026-07-15 reran verification flow
    - PD: Magic LVS / DRC / PEX + KLayout LVS / DRC clean
    - Top-Level: Magic DRC clean. KLayout has off-grid errors.
2026-07-16 renamed palace model folders
    [domain-E.csv, error-indicators.csv, port-I.csv, port-S.csv, port-V.csv]
2026-07-17 renamed palace model to `sparx160_core_data`
    [domain-E.csv, error-indicators.csv, port-I.csv, port-S.csv, port-V.csv]
2026-07-17 updated `README` and comments of the filter parameters
2026-07-21 added pin labels for lvs checks
2026-07-22 reran SPARX flow
    [sparx_powdet_sbd_hb_sweep_V-W_alo_100mV.csv, sparx_powdet_sbd_hb_sweep_V-W_alo_300mV.csv, sparx_powdet_sbd_hb_sweep_V-W_alo_30mV.csv, sparx_powdet_sbd_hb_sweep_V-W_ref.csv, sparx_powdet_sbd_hb_sweep_alo_100mV.csv, sparx_powdet_sbd_hb_sweep_alo_300mV.csv, sparx_powdet_sbd_hb_sweep_alo_30mV.csv, sparx_powdet_sbd_hb_sweep_ref.csv]
2026-07-22 executed `make regression` --> ready for `2026.07` IIC-OSIC-TOOLS release
    [domain-E.csv, error-indicators.csv, port-I.csv, port-S.csv, port-V.csv]
2026-07-22 [Server] executed make all and make release
    [domain-E.csv, error-indicators.csv, port-I.csv, port-S.csv, port-V.csv]
2026-07-28 relocated pin reorder scripts to IIC-OSIC-TOOLS container
2026-07-28 reworked circuit-level simulation flow
    - added `plot_simulations` structure for testbench plotting
    - moved plot scripts, `sim_data` (-> `data/`) and figures into `testbenches/plot_simulations/` (template-consistent)
    - added `plot_n_port_tb_acsp_ngspice.py` / `plot_n_port_tb_tran_ngspice.py` (via `ngspice2python.py`), renamed VACASK eval scripts to `plot_*_vacask.py`
    - `sim-xschem` now runs `ngspice -b` / `vacask` in batch mode; new `sim-view-xschem SCRIPT=<scriptname>` target
    - updated testbench `wrdata`/`postprocess` paths, fixed stale `.save` include (powdet) and HB netlist glob, updated `README.md` and `REUSE.toml`
    [sparx_blc_le_tb_acsp_ngspice.sch, sparx_blc_le_tb_acsp_vacask.sch, sparx_blc_le_tb_tran_ngspice.sch, sparx_bpf_le_tb_acsp_ngspice.sch, sparx_bpf_le_tb_acsp_vacask.sch, sparx_core_le_tb_acsp_ngspice.sch, sparx_core_le_tb_acsp_vacask.sch, sparx_core_le_tb_tran_ngspice.sch]
2026-07-28 added `xschem` folder layer for template and snp2le consistency
    - moved schematics to `schematic/xschem/` and the Xschem testbenches (incl. `xschemrc`, `sim_range.*`, `plot_simulations/`) to `testbenches/xschem/`, matching `ihp-sg13g2-ams-chip-template` and `snp2le`
    - renamed `SCH_DIR` to `XSCHEM_SCH_DIR` (= `schematic/xschem`); `XSCHEM_TB_DIR` = `testbenches/xschem`, `SIM_PLOT_DIR` = `testbenches/xschem/plot_simulations`; netlists now go to `testbenches/xschem/simulations/`
    - updated relative paths in all testbenches (`wrdata`, VACASK `postprocess`, netlist includes), both `xschemrc` files, and the plot script anchors
    - updated `.gitignore`, `REUSE.toml`, `regression.yml` artifact paths, an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
    [sparx_blc_le_tb_acsp_ngspice.sch, sparx_blc_le_tb_acsp_vacask.sch, sparx_blc_le_tb_tran_ngspice.sch, sparx_bpf_le_tb_acsp_ngspice.sch, sparx_bpf_le_tb_acsp_vacask.sch, sparx_core.sch, sparx_core_le_tb_acsp_ngspice.sch, sparx_core_le_tb_acsp_vacask.sch]
2026-07-29 updated plotting scripts for fancier plots
    [sparx_powdet_sbd_hb_sweep_V-W_alo_100mV.csv, sparx_powdet_sbd_hb_sweep_V-W_alo_300mV.csv, sparx_powdet_sbd_hb_sweep_V-W_alo_30mV.csv, sparx_powdet_sbd_hb_sweep_V-W_ref.csv, sparx_powdet_sbd_hb_sweep_alo_100mV.csv, sparx_powdet_sbd_hb_sweep_alo_300mV.csv, sparx_powdet_sbd_hb_sweep_alo_30mV.csv, sparx_powdet_sbd_hb_sweep_ref.csv]
2026-07-31 Reworked EM simulation GDS generation and Makefile flow
    `six_port_gen.py` now exports the BLC, WPD, BPF, and six-port core with their
    Palace port markers (layers 201..207) to `verification/em/layout/`, so the EM
    simulations always run on the same structures that are instantiated in the
    chip. The four standalone generator scripts in `verification/em/scripts/` are
    removed, together with their duplicated design parameters.
    The `sim-*-em` targets no longer generate geometry. They look up the GDS by its
    parameter-encoded name (`BLC_EM_NAME`, `WPD_EM_NAME`, `BPF_EM_NAME`,
    `CORE_EM_NAME`), abort with a hint to run `build-layout` if it is missing, and
    share a single `run-em-sim` recipe.
    `palace_si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
2026-07-31 shortened the EM structure names to the design frequency
    [domain-E.csv, error-indicators.csv, port-I.csv, port-S.csv, port-V.csv]
2026-07-31 update naming scheme
    [domain-E.csv, error-indicators.csv, port-I.csv, port-S.csv, port-V.csv]
2026-08-17 remove resistance input parameter for rsil
2026-08-18 update six port core em simulation flow with further included features
2026-08-19 SERVER updated sparx core simulation results
    [domain-E.csv, error-indicators.csv, port-I.csv, port-S.csv, port-V.csv]
2026-08-24 fix `rfin` pin to be inside TopMetal2 layer. Reran `make regression` without errors fixes #3
2026-08-27 added `mm_ok=1` to power detector schematic
    [sparx_powdet_sbd.sch]
2026-08-27 updated power detector PEX symbol
2026-08-27 updated testbenches with `temp` and `.save` fix
    [sparx_blc_le_tb_acsp_ngspice.sch, sparx_blc_le_tb_tran_ngspice.sch, sparx_bpf_le_tb_acsp_ngspice.sch, sparx_core_le_tb_acsp_ngspice.sch, sparx_core_le_tb_tran_ngspice.sch, sparx_core_tb_acsp_ngspice.sch, sparx_powdet_sbd_tb_ngspice.sch, sparx_top_le_tb_tran_ngspice.sch]
2026-08-28 log the stackup provenance in the EM runs
    The stackup is no longer vendored in this repository, it is read from
    $PDK_ROOT/$PDK/libs.tech/palace/workflow, so nothing in a committed result said
    which file produced it.
    IIC-OSIC-TOOLS writes the PDK git hash to $PDK_ROOT/$PDK/COMMIT when it installs
    the PDK. That hash pins the libs.tech/palace submodule, which is the stackup file
    itself, so printing it next to the resolved path identifies the stackup exactly:
    Stackup: /foss/pdks/ihp-sg13g2/libs.tech/palace/workflow/SG13G2_nosub.xml
    PDK commit: d592520846234ec601cd80300d7377d41340b5a5
    Outside the container it degrades to "unknown (...)" rather than failing.
    The stackups README do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
2026-08-30 SERVER sparx core em results
    [domain-E.csv, error-indicators.csv, port-I.csv, port-S.csv, port-V.csv]
2026-08-30 updated `sparx_powdet_sbd_tb_ngspice.sch`
    [sparx_powdet_sbd_tb_ngspice.sch]
2026-08-31 All generated layouts are DRC clean, except for antenna violations, these are okay and only affect dummy devices.
2026-09-04 updated schematics
    [sparx_top.sch, sparx_top_le.sch]
2026-09-04 added VACASK testbenches, processing scripts and figures
    [sparx_core_le_tb_tran_ngspice.sch, sparx_powdet_sbd_nf.csv, sparx_powdet_sbd_nf_lo.csv, sparx_powdet_sbd_nf_lo_m16.csv, sparx_powdet_sbd_nf_lo_m1_pex.csv, sparx_powdet_sbd_nf_m16.csv, sparx_powdet_sbd_nf_m1_pex.csv, sparx_powdet_sbd_pss.csv]
2026-09-04 reran simulations
    [sparx_powdet_sbd_nf_lo_m1_pex.csv, sparx_powdet_sbd_nf_m1_pex.csv, sparx_powdet_sbd_pss_check_m1_pex.csv, sparx_powdet_sbd_pss_m1_pex.csv, sparx_top_le_rx_if_m1_pex.csv, sparx_top_le_rx_lo_m1_pex.csv, sparx_top_le_rx_tran_m1_pex.csv]
2026-09-04 updated VACASK testbenches
    [sparx_powdet_sbd_tb_hb_vacask.sch, sparx_powdet_sbd_tb_nf_vacask.sch, sparx_powdet_sbd_tb_pss_vacask.sch, sparx_powdet_sbd_tb_tn_vacask.sch, sparx_top_le_tb_rx_vacask.sch]
2026-09-18 added HBNOISE simulations
    [sparx_powdet_sbd_nf.csv, sparx_powdet_sbd_nf_compare.csv, sparx_powdet_sbd_nf_lo.csv, sparx_powdet_sbd_nf_lo_m16.csv, sparx_powdet_sbd_nf_lo_m1_pex.csv, sparx_powdet_sbd_nf_m16.csv, sparx_powdet_sbd_nf_m1_pex.csv, sparx_powdet_sbd_pss.csv]
2026-09-29 updated groundplate spacing to sealring (reverted to old value)
2026-10-05 added `AGENTS.md` with the repository conventions for coding agents
    Codex, Copilot, Cursor and opencode read `AGENTS.md` by themselves, and Claude Code does when a checkout has no `CLAUDE.md`. It covers the template this repo follows, the container and the PDK guard, the layout, the Makefile conventions, the narrow targets for checking a change, CI, how the generator, the EM runs and the LE models stay consistent, the traps (committed build outputs, `make snp2le` without `LE_OUT=`, `make release` overwriting `v.2.0.0`, Open MPI slots) and the license headers.
    `REUSE.toml` annotates it next to `README.md`.
2026-10-06 checked the detector noise figure with `pac` and `pnoise` and moved the VACASK benches to `1b48553`
    The NF bench runs `pac` and `pnoise` around a shooting PSS of the LO next to `hbac` and `hbnoise`, and its plot script reports and plots the differences. They agree within 0.03 dB in conversion and 0.2 dB in output noise for all three detector versions. The residual is the harmonic truncation of `hbnoise`, while `pnoise` is converged in its harmonic count.
    The cross-check showed that nine harmonics are not converged above P(1 dB), so the two HB LO sweeps now run at 15 harmonics. The noise figure of the fabricated detector rises from 42.3 dB at -6.3 dBm to 45.9 dB at +6.9 dBm instead of fallin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
    [sparx_powdet_sbd_tb_nf_vacask.sch, sparx_powdet_sbd_tb_pss_vacask.sch, sparx_top_le_tb_rx_vacask.sch]
2026-10-06 reran the VACASK testbenches on VACASK `1b48553`
    NF bench: the `pac` and `pnoise` columns are appended to the CSVs and the LO sweep data comes from 15 harmonics. The fixed-LO results are bit-identical to the previous build.
    TN bench: the transient-noise realisation changed between the build of 2026-09-18 and the 2026.09 image's `89e888d`, and `1b48553` reproduces `89e888d` exactly. The noise figure moved by up to 0.6 dB and stays within 0.84 dB of `hbnoise`.
    Refreshed outputs that predated later changes: the acsp tables and figures of the BPF, WPD, BLC and composed core (committed on 2026-07-29, before the fits of 2026-08-30 and the current band), the two-tone HB figures (2026-07-29), and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
    [sparx_powdet_sbd_nf.csv, sparx_powdet_sbd_nf_compare.csv, sparx_powdet_sbd_nf_lo.csv, sparx_powdet_sbd_nf_lo_m16.csv, sparx_powdet_sbd_nf_lo_m1_pex.csv, sparx_powdet_sbd_nf_m16.csv, sparx_powdet_sbd_nf_m1_pex.csv, sparx_powdet_sbd_tn.csv]
2026-10-06 added `pnoise` to the detector noise-figure comparison
    The comparison figure of the transient-noise bench (`sparx_powdet_sbd_nf_compare.png`) now draws the `pnoise` noise figure as open circles next to `hbnoise`, the quiescent estimate and the transient ladder, all with the same `hbac` conversion in the denominator. `pnoise` sits within 0.1 dB of `hbnoise` over the whole IF range, which shows that the transient's offset of up to 0.84 dB belongs to the transient estimate.
    The script reads `pnoise` from the NF bench's JSON and keeps the three-curve figure when that run had none, as on the notebook's VACASK `89e888d`. The CSV and the TN JSON gain one column and one field, the existing ones are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
    [sparx_powdet_sbd_nf_compare.csv]
2026-10-06 reviewed the testbench README against the current results
    Corrected numbers that had gone stale: the transient-noise check within 11 percent in amplitude (was 17), the quiescent estimate 26 to 47 percent low (was 25 to 58), the receiver drift 6 to 9 uV/ns against 358 to 537 uV (was 7 to 10 and 526), about 98 percent of the pumped noise from the PCell PNP (97 of the quiescent), the replica's share at low IF, and the post-layout NF bench at 8 to 13 minutes.
    Documented the pac and pnoise outputs of the NF bench (the shooting_check block and the appended CSV columns), the TN bench's use of pnoise, op2 in the receiver's analysis table, the two-tone bench's run time, the PSS check CSV, and two ne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
2026-10-07 updated VACASK SPARX testbenches with `sparx_powdet_sbd_tb_tn_lo_vacask`
    [sparx_powdet_sbd_pss_check.csv, sparx_powdet_sbd_pss_check_m16.csv, sparx_powdet_sbd_pss_check_m1_pex.csv, sparx_powdet_sbd_tb_pss_vacask.sch, sparx_powdet_sbd_tb_tn_lo_vacask.sch, sparx_powdet_sbd_tn_lo.csv]
2026-10-07 re-exported the notebook PSS netlist with the nine shooting points
    The Code-a-Chip PSS netlist in `testbenches/xschem/netlists/` was exported before the low-drive PSS points were added and still ran five. It is now the netlist the schematic emits, identical to the one behind the committed PSS data. The NF, TN and receiver netlists already match their schematics. The testbench README no longer says that two netlists are held at the 2026.09 binary, since the notebook now runs the stored VACASK `1b48553` build.
2026-10-10 added top-level noise figure testbenches (four noise estimates)
    [sparx_top_le_nf.csv, sparx_top_le_nf_compare.csv, sparx_top_le_nf_lo.csv, sparx_top_le_nf_lo_m1_pex.csv, sparx_top_le_nf_m1_pex.csv, sparx_top_le_tb_nf_vacask.sch, sparx_top_le_tb_tn_vacask.sch, sparx_top_le_tn.csv]
2026-10-10 added the core's thermal noise to the full-core fit (`LE_NOISE=thermal`)
    `make snp2le` takes `LE_NOISE=noiseless|thermal` (default noiseless), and `sparx-core` fits the core with `LE_NOISE=thermal`, which runs snp2le with `--thermal-noise`: a generator computed from the fit adds the core's own thermal noise, kT(I - S S^H) at its seven ports, through seven noisy resistors `Rnz_e1` to `Rnz_e7`, while the fit's resistors stay `noisy=0`. The regenerated `sparx_core_le` netlists are the committed ones plus 2767 generator lines in each dialect, with no line removed or changed, and the fitted-core S-parameter benches reproduce their committed tables byte for byte in ngspice and VACASK.
    `plot_sparx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
    [sparx_top_le_nf.csv, sparx_top_le_nf_compare.csv, sparx_top_le_nf_lo.csv, sparx_top_le_tn.csv]
2026-10-10 reran the post-layout receiver NF bench with the noisy core
    Follow-up to 2eefb41. With the post-layout detectors the core carries 2.0e-5 to 3.2e-5 of the output noise at 2 GHz and adds 0.00009 to 0.00014 dB to NF_DSB, as as fabricated. The largest change in the results is 0.0008 dB, so every post-layout figure the README quotes holds (hbnoise, pnoise, the composition within -0.22 to +0.28 dB, pnoise - hbnoise over the LO drive -0.08 to +0.03 dB). The README carries the post-layout core share and the measured run time, 147 minutes of CPU, the pnoise LO sweep 82 of them at about 8 minutes per level, in place of the 3 hours, 1.7 hours and 10 minutes it stated before.
    [sparx_top_le_nf_lo_m1_pex.csv, sparx_top_le_nf_m1_pex.csv]
2026-10-28 switched `klayout-pex` to the kpex 2.5D engine, which needs kpex 0.6.12 or later
    klayout-pex#148 is fixed in kpex 0.6.12, checked on 2026-10-26 with kpex 0.6.12 installed into the 2026.10 image, which ships 0.6.8. `klayout-pex` now runs `kpex extract --2.5D` instead of the Magic engine. It passes the CDL netlist of `klayout-lvs-netlist` as schematic, because kpex runs its own LVS and reads the schematic as SPICE. It reduces the full-RC netlist with TICER, because ngspice with KLU finds no operating point for the unreduced one. It uses the dashed option names of kpex 0.6.10, and `scripts/tie_pex_substrate.py` ties the substrate port `sub!` of the 2.5D netlist to `PEX_SUB_NET` (default `vss`),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
2026-10-30 turned off pip's conflict report in the Code-a-Chip install cell and restored Colab's decorator with its IPython
    kfactory 3.0, which gdsfactory 9.51.0 needs, requires newer requests, toolz and cachetools than google-colab, ibis-framework and pymc declare on Colab. The notebook does not use those pins, so `--no-warn-conflicts` removes the resolver errors. IPython and decorator go back to the kernel's versions, which clears the google-colab and moviepy conflicts.
2026-10-30 highlighted in the Code-a-Chip notebook that the regular-level DRC violations are known and waived
    A note before the DRC cell states that the 33 violations are antenna violations that IHP waived for the March 2026 tapeout, and a result box after the violation count lists each rule with its count and cause from `KNOWN_ISSUES.md`.
2026-10-30 added a `FULL_RUN` switch to the Code-a-Chip notebook that skips the DRC and the three longest simulations
    With `FULL_RUN = 1`, the default, the notebook regenerates every output, which takes one to two hours on Colab. With `FULL_RUN = 0`, it skips the DRC with its violation count, the detector transient noise, the receiver, and the receiver noise figure, and their stored outputs are not regenerated. That run took 4.0 min in a Colab-like container on two cores. A note after the reading guide lists the skipped cells.
    The runtime in the abstract, the reading guide, the notes of Sections 2 and 5, and the README now reads one to two hours, and the regular DRC about 10 minutes, the time of the s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
2026-10-31 stated the noise figure, NEP and coupling efficiency of the 16-cell detector in the abstract, Section 5.4 and the conclusion of the Code-a-Chip notebook
2026-10-31 switched the Code-a-Chip notebook from the tag to the branch `CaC-ISSCC2027`, which Colab can connect a runtime for
2026-11-02 referenced the RF circuit simulation appendix of the RFIC course in the docs (TIP box in the circuit simulation section) and the testbench README
2026-11-07 added `gdscheck-drc` targets and made KLayout and gdscheck the DRC of all flows
2026-11-11 added SPARX March 2026 TO die shots
2026-11-11 added the die photo to the README and the documentation
    The docs no longer say that the measurements wait for the chips to be delivered.
