iic-jku/SG13CMOS_SPARX/(notices)

Notices in the files:
sscs-ose-code-a-chip/README.md:
License: Solderpad Hardware License v2.1
